yilverdeja/sensordisplay/README.md

# Sensor Display: Hardware Project
In this project, I'm designing two PCBs: The main PCB holds an ATMega2560, an OLED display and a USB, whilst the second PCB holds the sensor. The OLED display shows the data retrieved from the sensor.

## Abbreviations
* MB: Main Board
* SM: Sensor Module
* TSM: Temperature Sensor Module

## Sensor Display Boards
* [Main Board v3](https://github.com/yilverdeja/sensordisplay/tree/master/mb_versions/v3)
* [ADT7410 Sensor Module v1](https://github.com/yilverdeja/sensordisplay/tree/master/sensor_modules/adt7410)
