yilverdeja/sensordisplay/mb_versions/v2/README.md

# Main Board v2
This is the second version of the Main Board PCB for the sensor display.

## Changes from v1
* Removed second header for sensor module since it isn't necessary for this current PCB
* Removed Test Points and replaced it with a 2x4 female header since it's less clunky
* Exposed the transmission pins (TX/RX)
* Added a top and bottom copper area.

## Top View
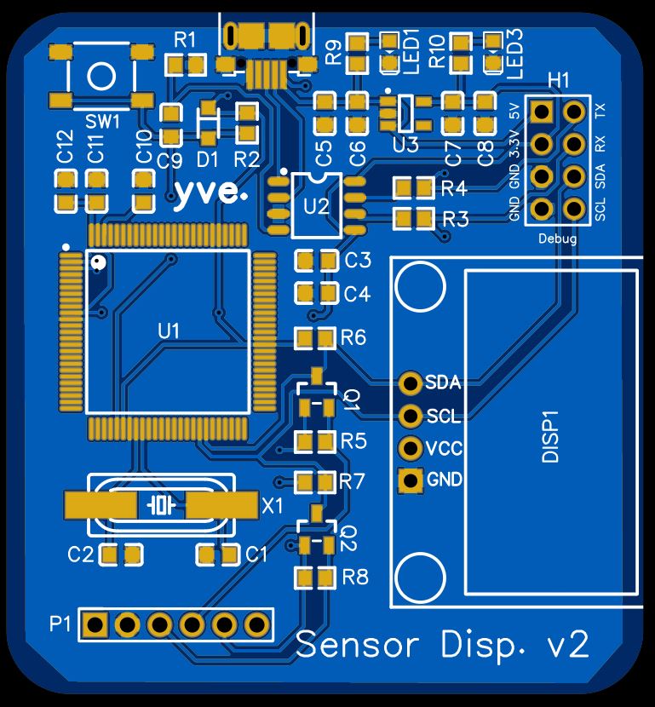
[picture p7: mb_versions/v2/SD_v2_topview.JPG]


## Bottom View
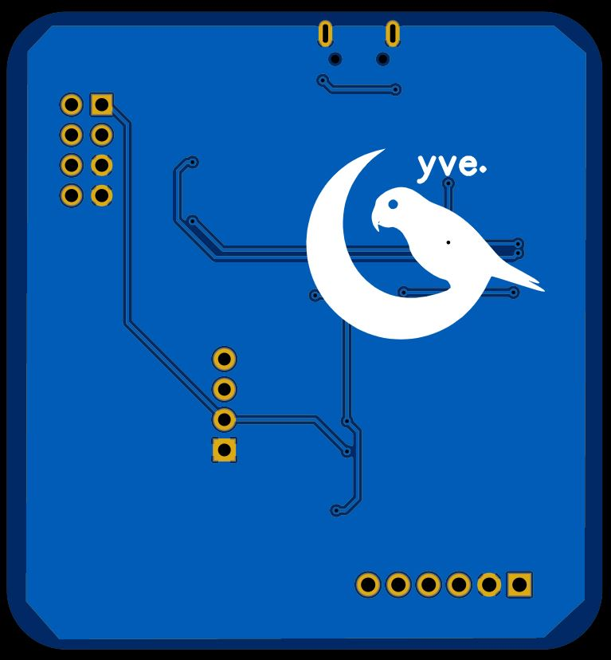
[picture p8: mb_versions/v2/SD_v2_bottomview.JPG]


[topview]: https://github.com/yilverdeja/sensordisplay/blob/master/mb_versions/v2/SD_v2_topview.JPG "Main Board v2 Top View"
[bottomview]: https://github.com/yilverdeja/sensordisplay/blob/master/mb_versions/v2/SD_v2_bottomview.JPG "Main Board v2 Bottom View"
