yilverdeja/sensordisplay/mb_versions/v3/SD_v3_BOM.pdf

ID | Name | Designator | Quantity | Part ID | Supplier | Manufacturer | Supplier Part | Price (HKD) | Supplier Part Link | Comments
1 | 0603 Cap 22pF | C1, C2 | 2
1 | Taobao / Telesky | 6.29 | https://detail.tmall.com/item.htm?id=41231814882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 (https://detail.tmall.com/item.htm?id=41231814882&cm_id=140105335569ed55e27b&abbucket=14&skuId=3984688435804) Minimum 100, 5%, 50V (TC: 6.29)
2 | LCSC | YAGEO | C519390 | 0.0243 | https://lcsc.com/product-detail/Multilayer-Ceramic-Capacitors-MLCC-SMD-SMT_YAGEO-CC0603JRNPO8BN220_C519390.html Minimum 50, 5%, 25V (TC: 1.22)
2 | 0603 Cap 10uF | C3, C5, C7, C12 | 4
1 | Taobao / Telesky | 11.91 | https://detail.tmall.com/item.htm?id=41231814882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 (https://detail.tmall.com/item.htm?id=41231814882&cm_id=140105335569ed55e27b&abbucket=14&skuId=3984688435812) Minimum 100, 10%, 10V (TC: 11.91)
2 | LCSC | Samsung Electro Mechanics | C95839 | 0.103 | https://lcsc.com/product-detail/Multilayer-Ceramic-Capacitors-MLCC-SMD-SMT_SAMSUNG_CL10A106KQ8NNNC_10uF-106-10-6-3V_C95839.html Minimum 50, 10%, 10V (TC: 5.16)
3 | 0603 Cap 0.1uF | C4, C6, C8, C9, C10, C11 | 6
1 | Taobao / Telesky | 8.88 | https://detail.tmall.com/item.htm?id=41231814882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 (https://detail.tmall.com/item.htm?id=41231814882&cm_id=140105335569ed55e27b&abbucket=14&skuId=3984688435815) Minimum 100, 10%, 16V (TC: 8.88)
2 | LCSC | YAGEO | C108079 | 0.0296 | https://lcsc.com/product-detail/Others_YAGEO-CC0603KRX7R7BB104_C108079.html Minimum 50, 10%, 16V (TC: 1.48)
4 | 1N4148WS | D1 | 1
1 | LCSC | VISHAY INTE... | C448648 | 0.259 | https://lcsc.com/product-detail/Switching-Diode_Vishay-Intertech-1N4148WS-E3-18_C435853.html Minimum 20 (TC: 5.18)
2 | Taobao / RiSyn | 3.83 | https://detail.tmall.com/item.htm?id=18488641564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 (https://detail.tmall.com/item.htm?id=18488641564&ns=1&abbucket=14&skuId=4477794395443) Minimum 100, SOD323 (TC: 3.83)
5 | OLED SSD1306 0.96' I2C | DISP1 | 1
1 | Taobao / Jin Yichen Electronics | 11 | https://item.taobao.com/item.htm?spm=a230r.1.14.94.13f35268s5n3zH&id=598566162941&ns=1&abbucket=14#detail (https://item.taobao.com/item.htm?id=598566162941&ns=1&abbucket=14) Minimum 1 (TC: 11)
2 | Taobao / Telesky | 24.29 | https://detail.tmall.com/item.htm?id=42044259331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 (https://detail.tmall.com/item.htm?id=42044259331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) Minimum 1 (TC: 24.29)
6 | Header Female 2x6 | H1 | 1 | 1 | LCSC | BOOMELE | C36191 | 0.428 | https://lcsc.com/product-detail/Pin-Header-Female-Header_BOOMELE-Boom-Precision-Elec-C36191_C36191.html Minimum 10 (TC: 4.28)
7 | Header Female 1x6 | H2 | 1 | 1 | LCSC | BOOMELE | C40877 | 0.404 | https://lcsc.com/product-detail/Pin-Header-Female-Header_BOOMELE-Boom-Precision-Elec-C40877_C40877.html Minimum 10 (TC: 4.04)
8 | 0603 Green LED | LED1, LED2 | 2 | 1 | LCSC | LITEON | C72043 | 0.135 | https://lcsc.com/product-detail/Light-Emitting-Diodes-LED_SMD-green_C125094.html Minimum 20 (TC: 2.71)
9 | BSS138 | Q1, Q2 | 2
1 | LCSC | FAIRCHILD | C52895 | 0.32 | https://lcsc.com/product-detail/MOSFET_ON-Semiconductor-ON-BSS138_C52895.html Minimum 10 (TC: 3.2)
2 | Taobao / Telesky | 4.2 | https://detail.tmall.com/item.htm?id=41248470416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 (https://detail.tmall.com/item.htm?id=41248470416&rn=c12fe3e92e7b747fb9670a979aa08d6b&abbucket=8) Minimum 20 (TC: 4.20)
10 | 0603 Res 1k | R1, R2, R3, R4 | 6 | 1
Taobao / Telesky | 2.97 | https://detail.tmall.com/item.htm?id=550090219082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 (https://detail.tmall.com/item.htm?id=550090219082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) Minimum 100, 1% (TC: 2.97)
LCSC | KOA | C160009 | 0.0213 | https://lcsc.com/product-detail/Chip-Resistor-Surface-Mount_1KR-1001-1_C160009.html Minimum 100, 1% (TC: 2.13)
11 | 0603 Res 10k | R5, R6, R7, R8 | 4 | 1
Taobao / Telesky | 2.97 | https://detail.tmall.com/item.htm?id=550090219082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 (https://detail.tmall.com/item.htm?id=550090219082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) Minimum 100, 1% (TC: 2.97)
LCSC | ROHM | C253330 | 0.144 | https://lcsc.com/product-detail/Chip-Resistor-Surface-Mount_ROHM-Semicon-ESR03EZPF1002_C510087.html Minimum 20, 1%, (TC: 2.89)
12 | 0603 Res 140 ohm | R9 | 1 | 1 | LCSC | Walsin Tech Corp | C170466 | 0.0119 | https://lcsc.com/product-detail/Chip-Resistor-Surface-Mount_Walsin-Tech-Corp-WR06X1400FTL_C170466.html Minimum 100, 1%, (TC: 1.19)
13 | 0603 Res 56 ohm | R10 | 1 | 1 | LCSC | Walsin Tech Corp | C384209 | 0.00737 | https://lcsc.com/product-detail/Chip-Resistor-Surface-Mount_Walsin-Tech-Corp-Walsin-Tech-Corp-56R-560-5_C384209.html Minimum 100, 5%, (TC: 0.74)
14 | Button | SW1 | 1 | 1 | LCSC | C&K | C221729 | 4.07 | https://lcsc.com/product-detail/Tactile-Switches_C-K_KSC223JLFG_C-K-KSC223JLFG_C221729.html Minimum 1 (TC: 4.07)
15 | ATMEGA2560 | U1 | 1
1 | LCSC | MICROCHIP | C22460 | 56.033 | https://lcsc.com/product-detail/ATMEL-AVR_MICROCHIP_ATMEGA2560-16AU_ATMEGA2560-16AU_C22460.html Minimum 1 (TC: 56.033)
2 | Taobao / YouXin Electronics | 27.8 | https://item.taobao.com/item.htm?spm=a230r.1.14.227.2b1d5ad1Ugb4yP&id=522554699765&ns=1&abbucket=14#detail (https://item.taobao.com/item.htm?id=522554699765&ns=1&abbucket=14) Minumum 1 (TC: 27.8)
16 | CH330N | U2 | 1
1 | LCSC | WCH | C108996 | 3.991 | https://lcsc.com/product-detail/USB-ICs_WCH-Jiangsu-Qin-Heng-CH330N_C108996.html Minimum 1 (TC: 3.991)
2 | Taobao / Xianhecheng | 1.4 | https://item.taobao.com/item.htm?spm=a230r.1.14.55.1d9941f7jGweyX&id=618847289382&ns=1&abbucket=14#detail (https://item.taobao.com/item.htm?id=618847289382&ns=1&abbucket=14) Minimum 1 (TC: 1.4)
17 | AP2112K-3.3TRG1 | U3 | 1
1 | LCSC | DIODES | C51118 | 1.001 | https://lcsc.com/product-detail/Dropout-Regulators-LDO_Diodes-Incorporated_AP2112K-3-3TRG1_Diodes-Incorporated-AP2112K-3-3TRG1_C51118.html Minumum 5 (TC: 5.005)
2 | Taobao / Xikke Zhineng | 0.3 | https://item.taobao.com/item.htm?spm=a230r.1.14.62.52b12ca92aO4FN&id=595984907928&ns=1&abbucket=14#detail (https://item.taobao.com/item.htm?id=595984907928&ns=1&abbucket=14) Minumum 1 (TC: 0.3)
18 | Micro USB | USB1 | 1 | 1 | LCSC | SHOU HAN | C393940 | 0.201 | https://lcsc.com/product-detail/USB-Connectors_SHOU-HAN-MICRO5-9mmusb_C393940.html Minimum 20 (TC: 4.02)
19 | 16MHz Crystal | X1 | 1
1 | LCSC | TAE | C111377 | 0.792 | https://lcsc.com/product-detail/SMD-Crystal-Resonators_TAE-Zhejiang-Abel-Elec-HC-49SM16MHz20pF30ppm_C111377.html Minimum 5 (TC: 3.96)
2 | Taobao / RiSyn | 3.03 | https://detail.tmall.com/item.htm?id=19581543502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 (https://detail.tmall.com/item.htm?id=19581543502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) Minimum 10 (TC: 3.03)
