yilverdeja/sensordisplay/mb_versions/v3/SD_v3_schematic.pdf

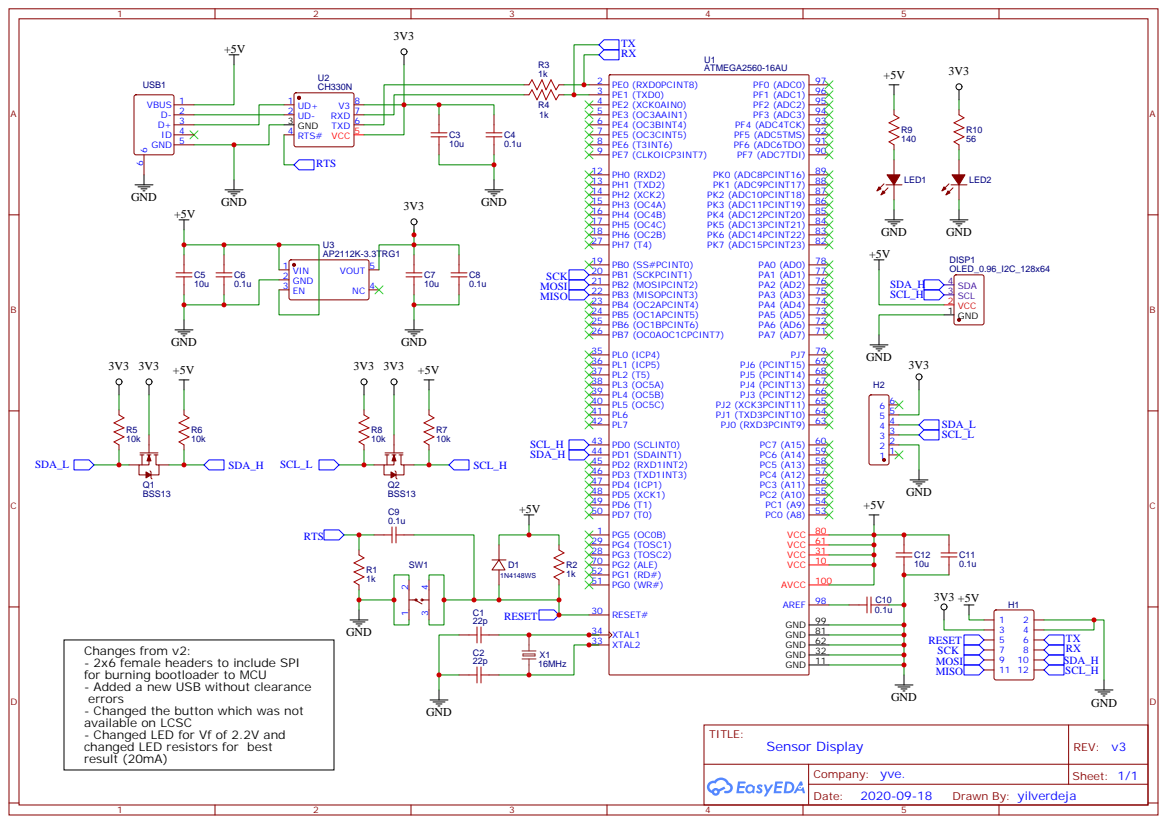
[picture p9: page 1]

Changes from v2:
- 2x6 female headers to include SPI
for burning bootloader to MCU
- Added a new USB without clearance
errors
- Changed the button which was not
available on LCSC
- Changed LED for Vf of 2.2V and
changed LED resistors for best
result (20mA)
