yilverdeja/sensordisplay/sensor_modules/adt7410/TSM_v1_schematic.pdf

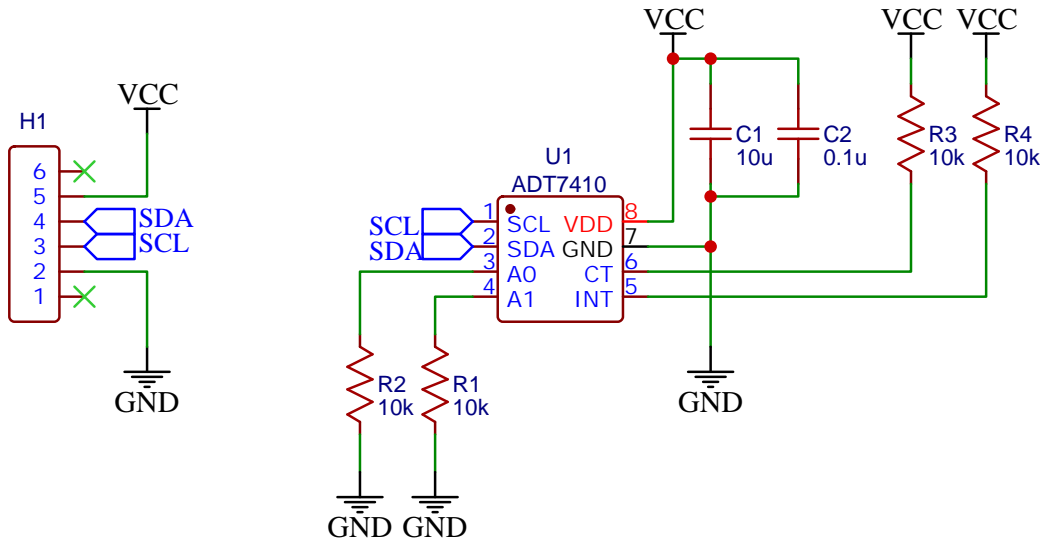
[picture p10: page 1]
