yilverdeja/sensordisplay/mb_versions/v3/SD_v3_merged_layers.pdf

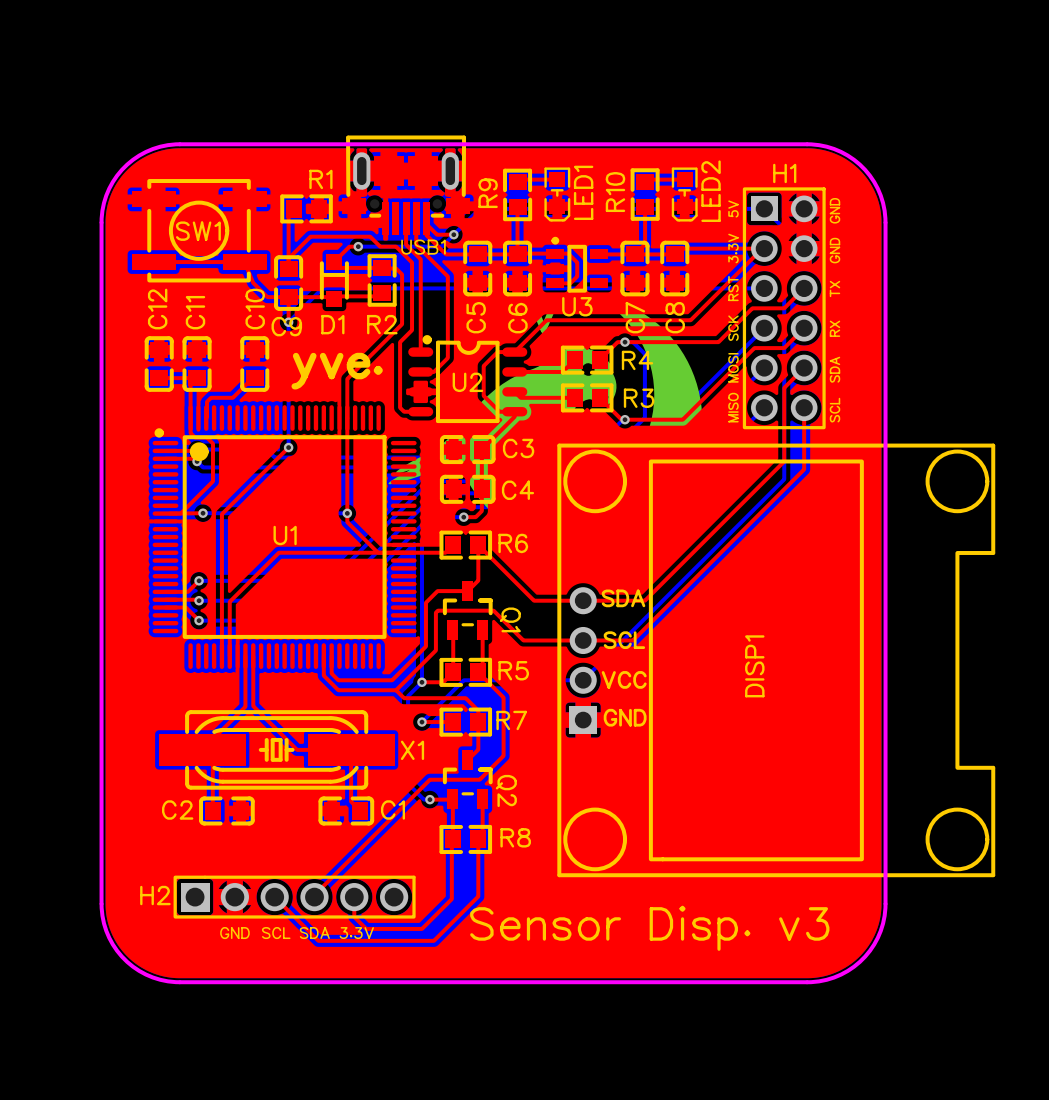
[picture p11: page 1]
