yilverdeja/sensordisplay/sensor_modules/adt7410/TSM_v1_merged_layers.pdf

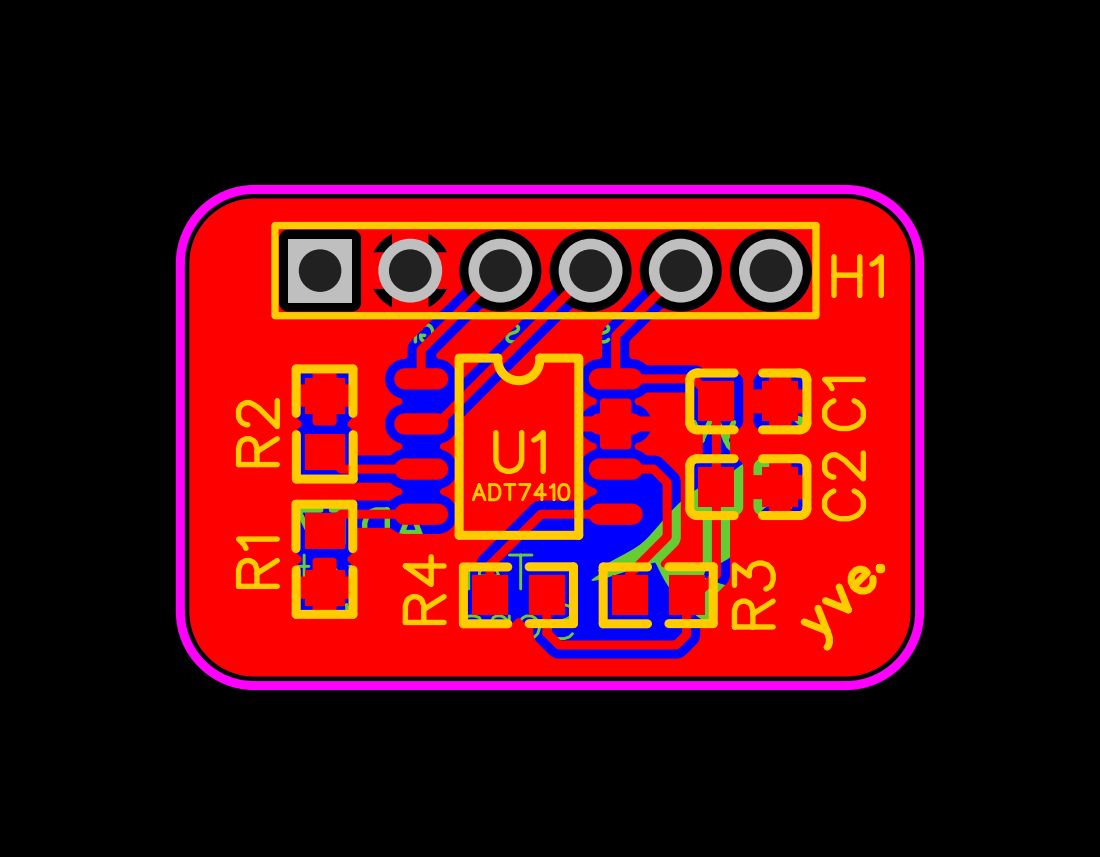
[picture p12: page 1]
