yilverdeja/sensordisplay/mb_versions/v1/SD_v1_schematic.pdf

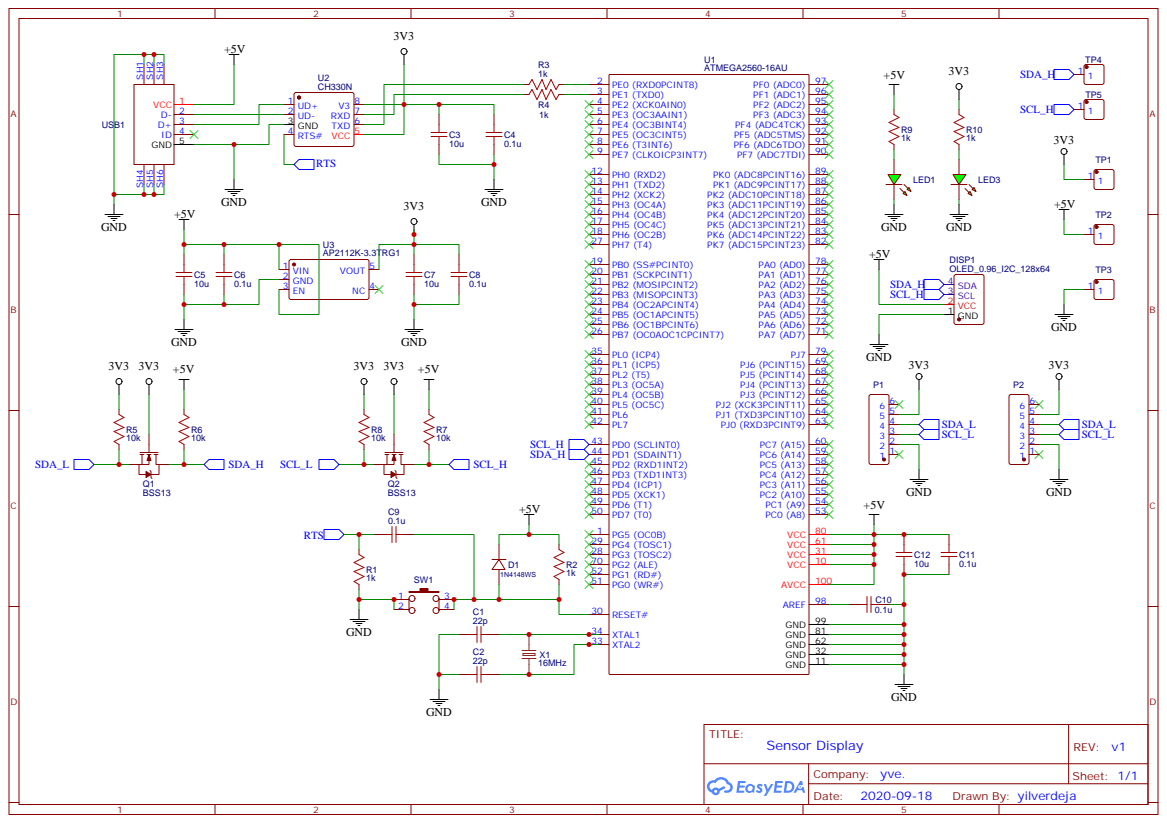
[picture p13: page 1]
