yilverdeja/sensordisplay/mb_versions/v2/SD_v2_schematic.pdf

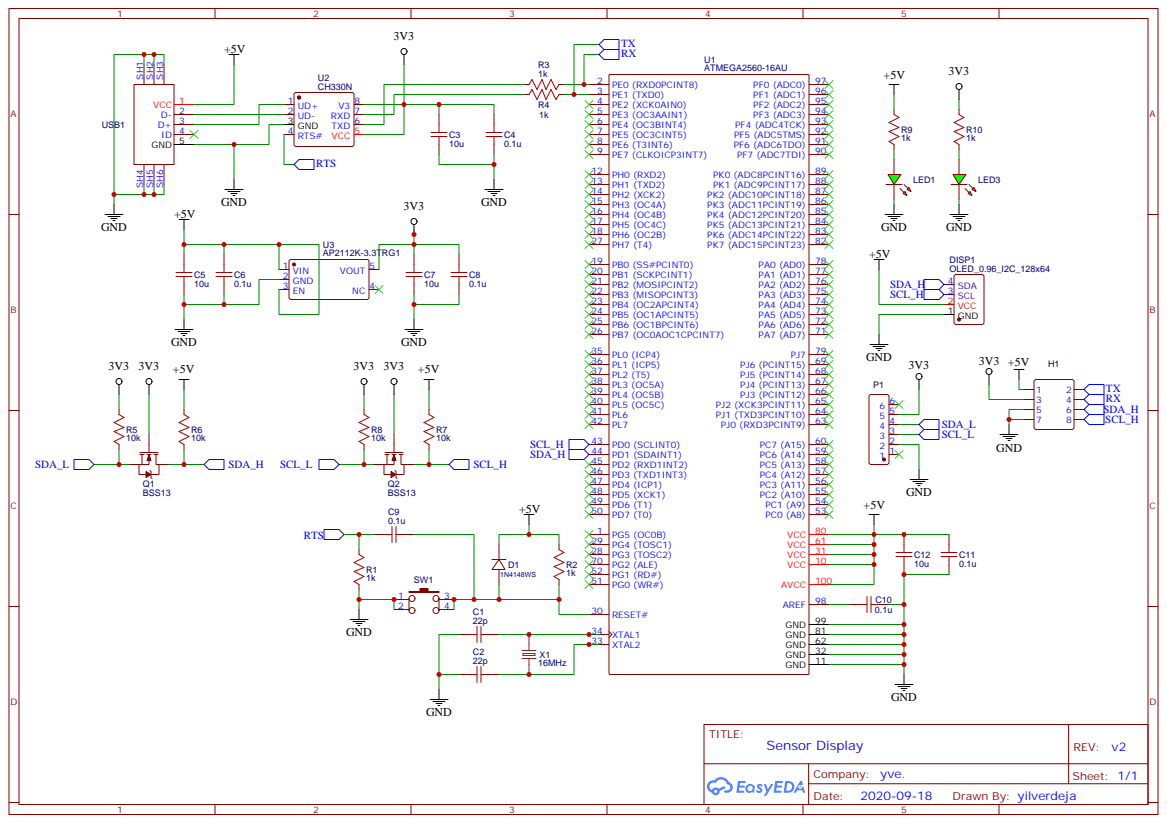
[picture p14: page 1]
