yilverdeja/sensordisplay/mb_versions/v1/SD_v1_merged_layers.pdf

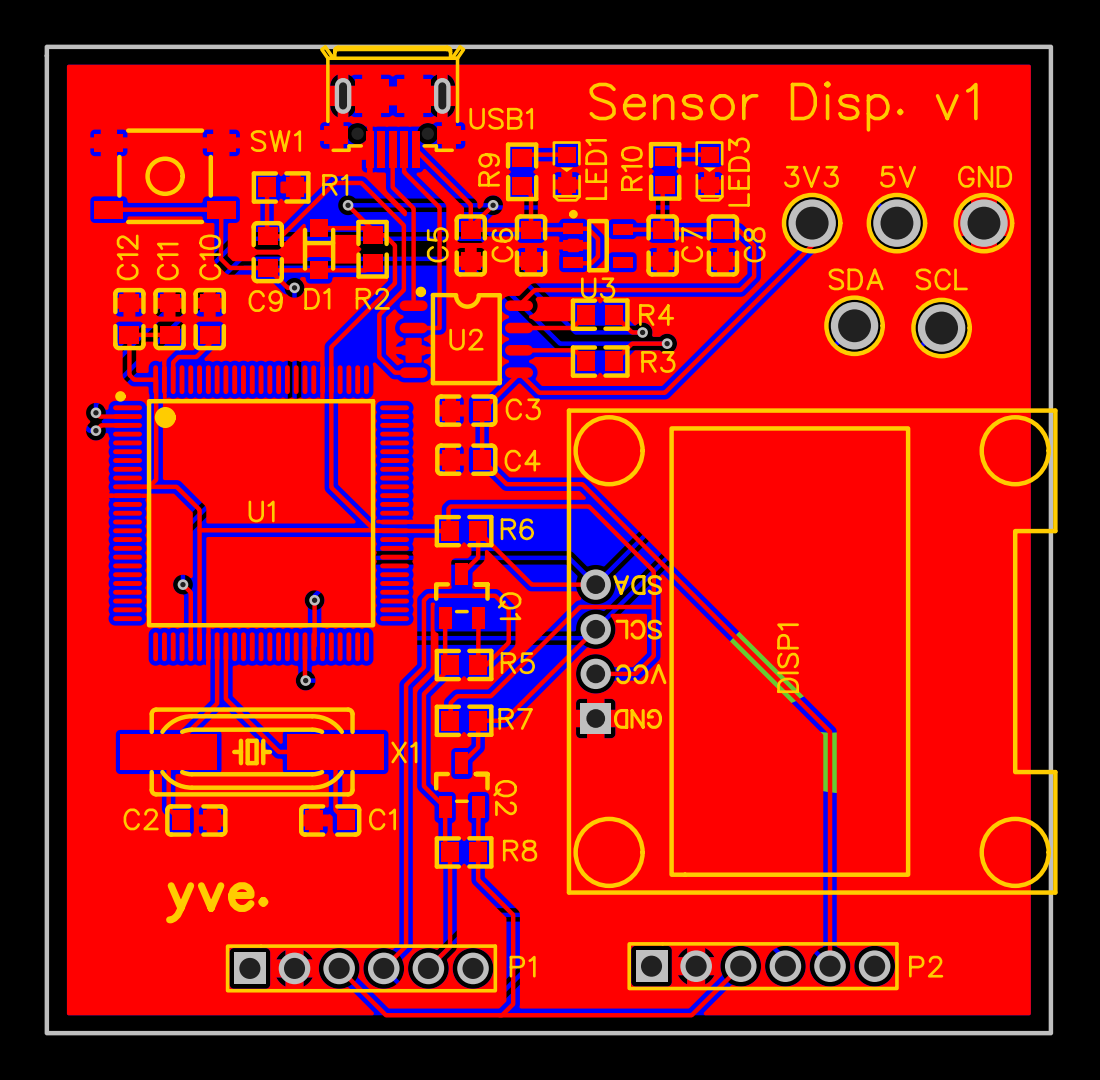
[picture p15: page 1]
