yilverdeja/sensordisplay/mb_versions/v2/SD_v2_merged_layers.pdf

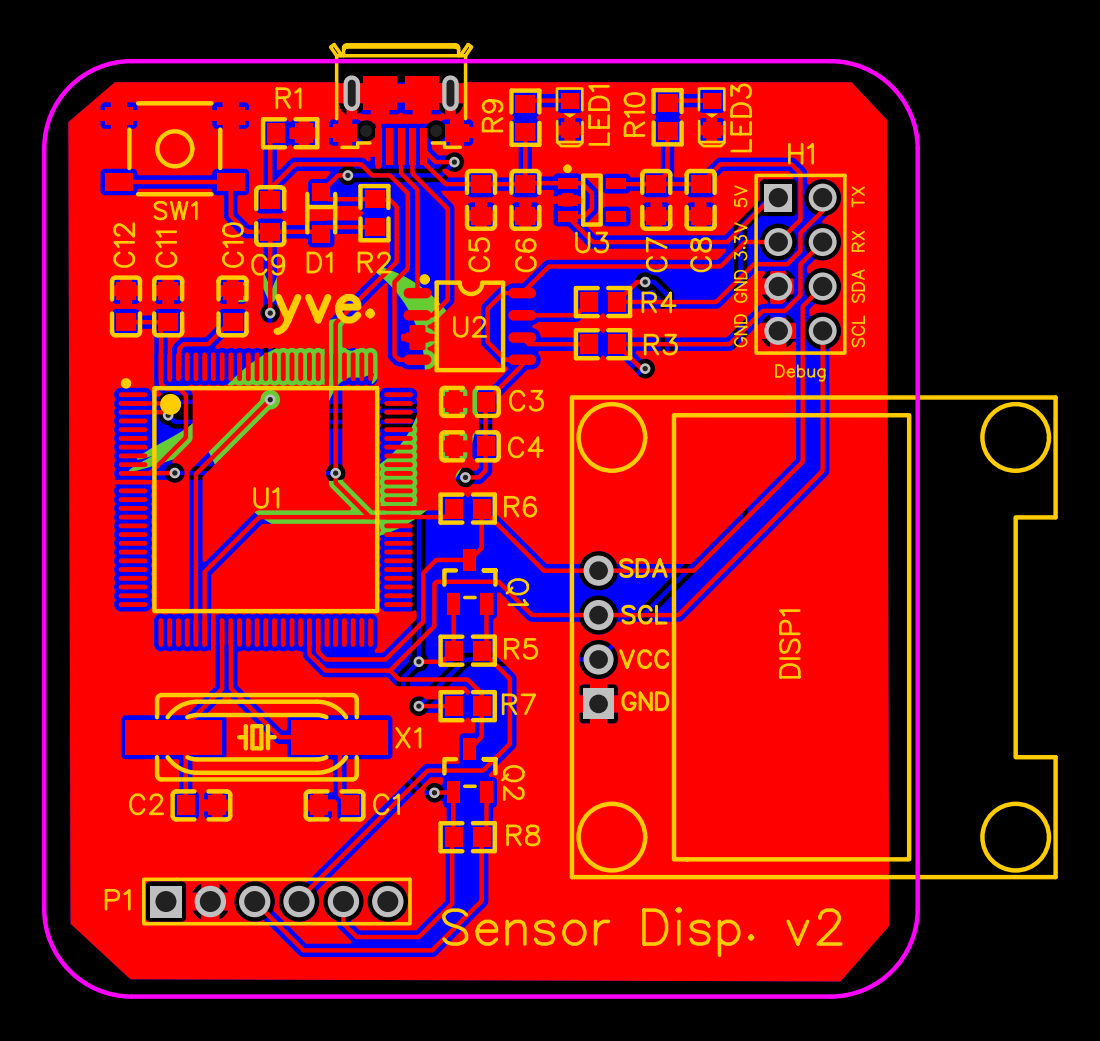
[picture p16: page 1]
