yilverdeja/sensordisplay/mb_versions/v0/PHC1.pdf

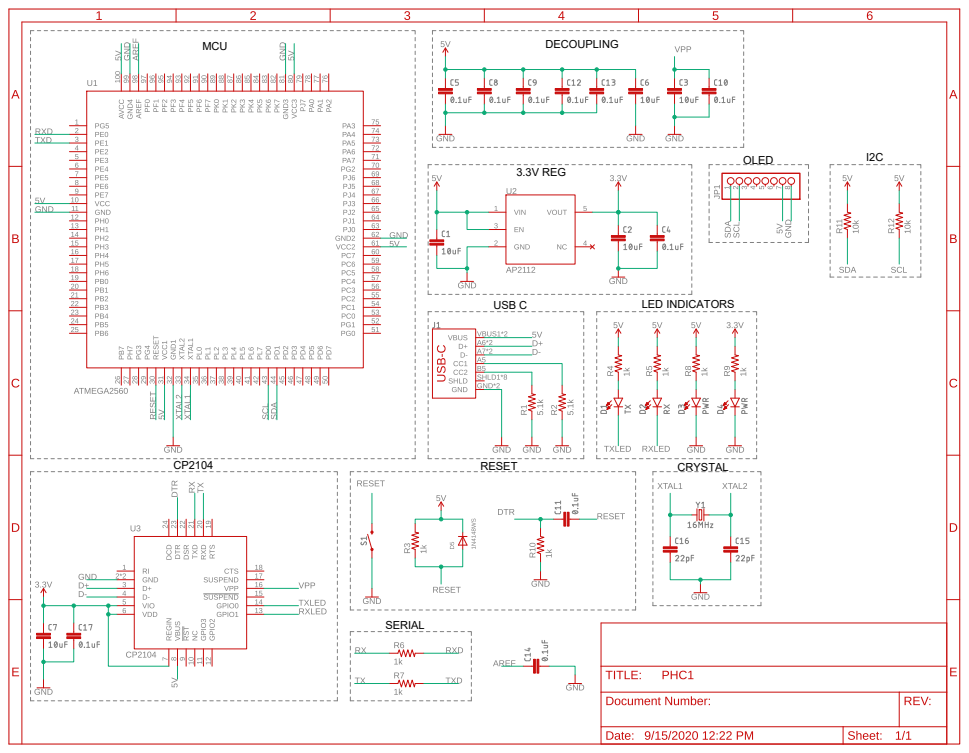
[picture p17: page 1]
