yilverdeja/sensordisplay/(threads)

Thread 1 (2020-09-19):

Add a way to burn the Arduino Bootloader to the ATMega2560 on the main board

yilverdeja, 2020-09-19:
Most likely, the ATMega2560 will not be bootloaded with the Arduino IDE. Add the SPI pins + Reset pin on a header to burn the bootloader on the ATMega2560 using an external Arduino Microcontroller.

yilverdeja, 2020-09-19:
Done on v3

Closed 2020-09-19.

Thread 2 (2020-09-20):

LEDs and Resistors

yilverdeja, 2020-09-20:
Find appropriate combinations between LEDs and resistors. The LED currently used as a typical forward voltage of 3.3V running at 20mA. Therefore from 5V - 3.3V, you will need 85 ohm resistor (~100 ohm) in series.

To get the 3.3V power led indicator working, you can use a bjt switch that connects 5Vs to the LED or use a different LED with a different forward voltage that fits the 3.3V.

yilverdeja, 2020-09-21:
Done in v3 fix update!

Closed 2020-09-21.
