yilverdeja/sensordisplay/code/SensorDisplay/SensorDisplay.ino

#include <Wire.h>
#include <Adafruit_GFX.h>
#include <Adafruit_SSD1306.h>
#include <Adafruit_ADT7410.h>

#define SCREEN_WIDTH 128 // OLED display width, in pixels
#define SCREEN_HEIGHT 64 // OLED display height, in pixels

// Create the ADT7410 temperature sensor object
Adafruit_ADT7410 tempsensor = Adafruit_ADT7410();

// Declaration for an SSD1306 display connected to I2C (SDA, SCL pins)
#define OLED_RESET     -1 // Reset pin # (or -1 if sharing Arduino reset pin)
Adafruit_SSD1306 display(SCREEN_WIDTH, SCREEN_HEIGHT, &Wire, OLED_RESET);\

void setup() {  
  Serial.begin(115200);

  // SSD1306_SWITCHCAPVCC = generate display voltage from 3.3V internally
  if(!display.begin(SSD1306_SWITCHCAPVCC, 0x3C)) { // Address 0x3C for 128x64
    Serial.println(F("SSD1306 allocation failed"));
    for(;;); // Don't proceed, loop forever
  }

  // Create an initial buffer
  display.clearDisplay();
  display.setCursor(0, 0);     // Start at top-left corner
  display.setTextColor(SSD1306_WHITE); // Draw white text
  display.cp437(true);         // Use full 256 char 'Code Page 437' font
  
  display.setTextSize(2);
  display.println("Sensor");
  display.println("Display");
  display.setTextSize(1);
  display.println("yve.");
  display.display();
  delay(2000);

  
  // Clear the buffer
  display.clearDisplay();
  display.setTextSize(2);
  display.setTextColor(SSD1306_WHITE); // Draw white text
  display.setCursor(0, 0);     // Start at top-left corner
  display.cp437(true);         // Use full 256 char 'Code Page 437' font
  
  // Make sure the sensor is found, you can also pass in a different i2c
  // address with tempsensor.begin(0x49) for example
  if (!tempsensor.begin()) {
    Serial.println("Couldn't find ADT7410!");
    while (1);
  }

  // sensor takes 250 ms to get first readings
  delay(250);

}

void loop() {
  // Clear the buffer
  display.clearDisplay();
  display.setCursor(0, 0);     // Start at top-left corner
  
  // Read and print out the temperature, then convert to *F
  float c = tempsensor.readTempC();
  float f = c * 9.0 / 5.0 + 32;
  Serial.print("Temp: "); Serial.print(c); Serial.print("*C\t"); 
  Serial.print(f); Serial.println("*F");
  
  delay(1000);
//  String temperatureDisplay = "Temperature: "+String(c)+(char)223+"C";
  String temperatureDisplay = String(c)+(char)223+"C";
  display.println(temperatureDisplay);
  display.display();

}
