yilverdeja/sensordisplay/(commit log)

2020-09-18 main pcb added v1, v2
2020-09-19 temperature sensor module
2020-09-21 v3 small fixes + bom's
